terrencelei/Autonomous-Shopping-Cart/docs/assets/cartview-poster.jpg

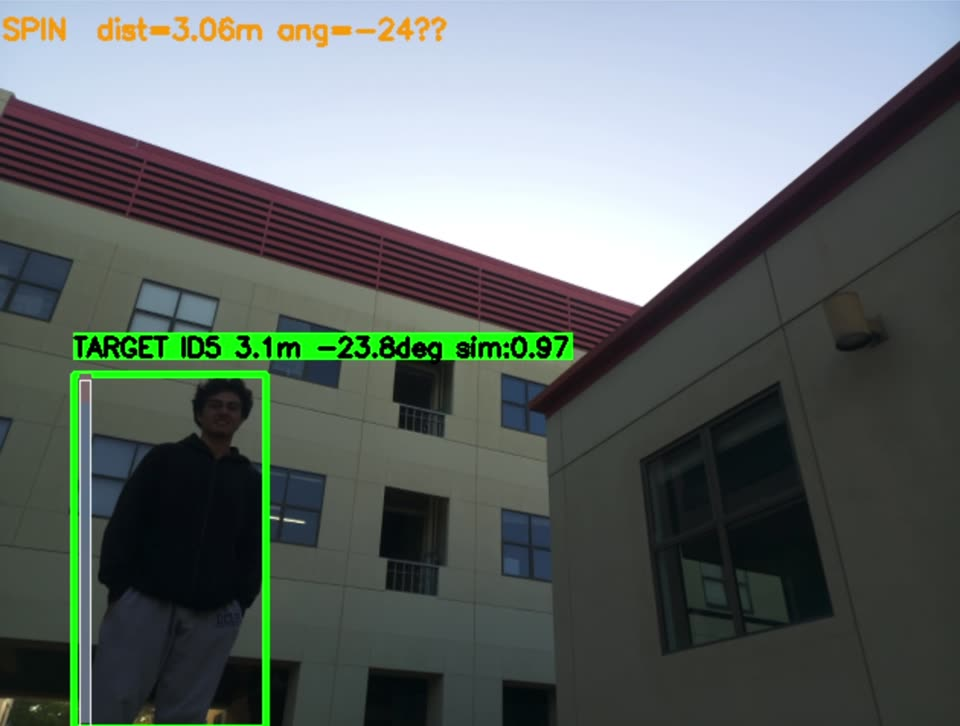
docs/assets/cartview-poster.jpg
