terrencelei/Autonomous-Shopping-Cart/docs/assets/follow-poster.jpg

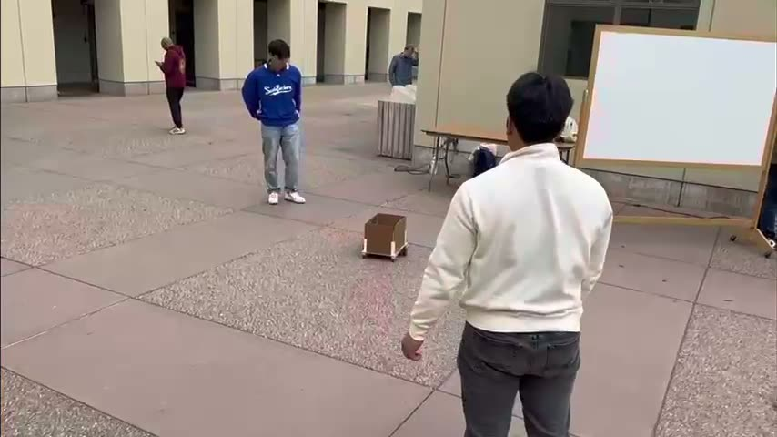
docs/assets/follow-poster.jpg
