terrencelei/Autonomous-Shopping-Cart/docs/assets/cad.jpg

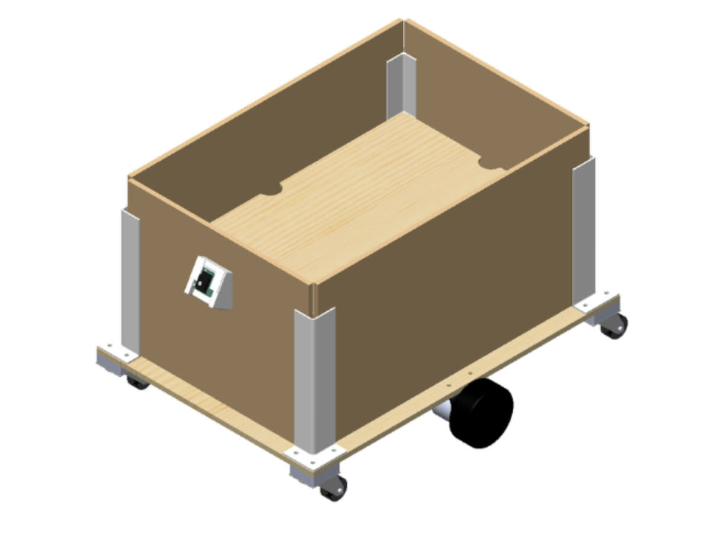
docs/assets/cad.jpg
