terrencelei/Autonomous-Shopping-Cart/docs/assets/cart-photo.jpg

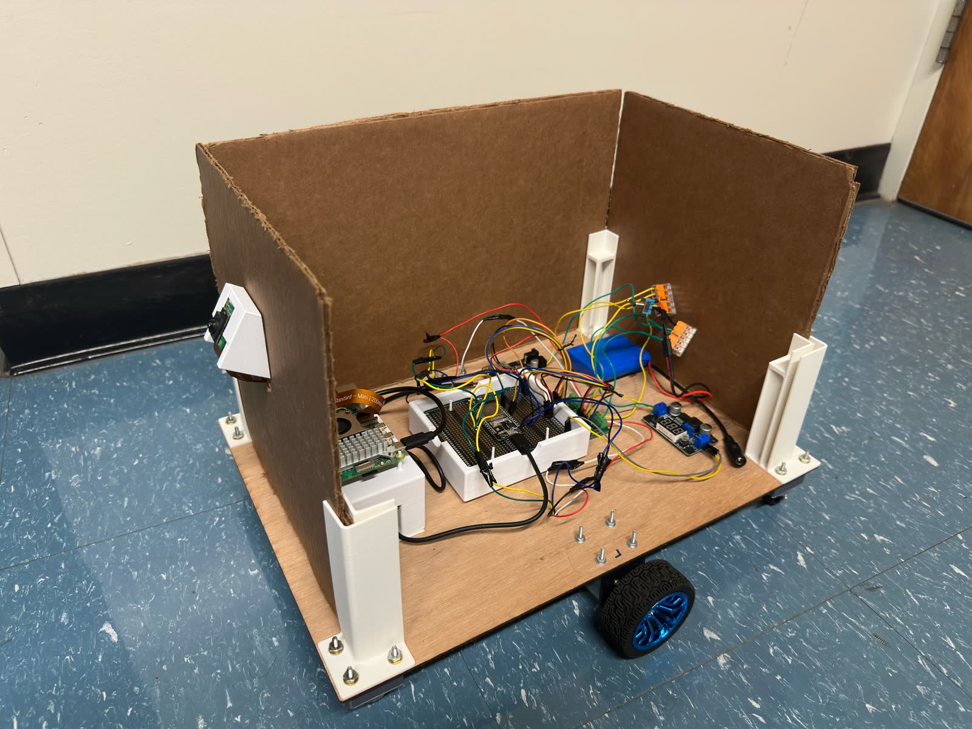
docs/assets/cart-photo.jpg
