terrencelei/Autonomous-Shopping-Cart/docs/assets/og.jpg

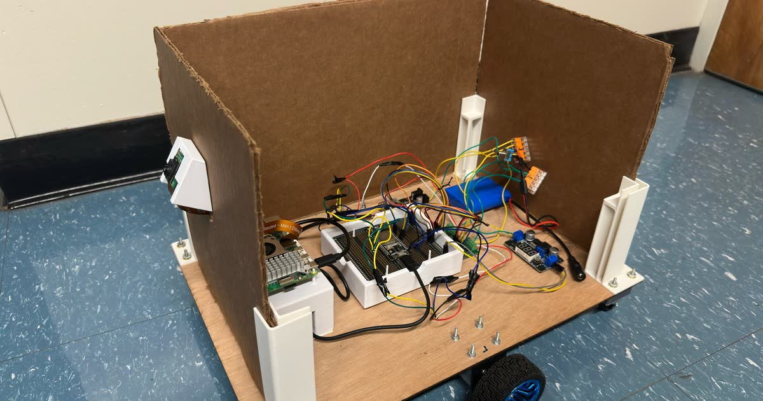
docs/assets/og.jpg
