terrencelei/Autonomous-Shopping-Cart/docs/assets/vision.jpg

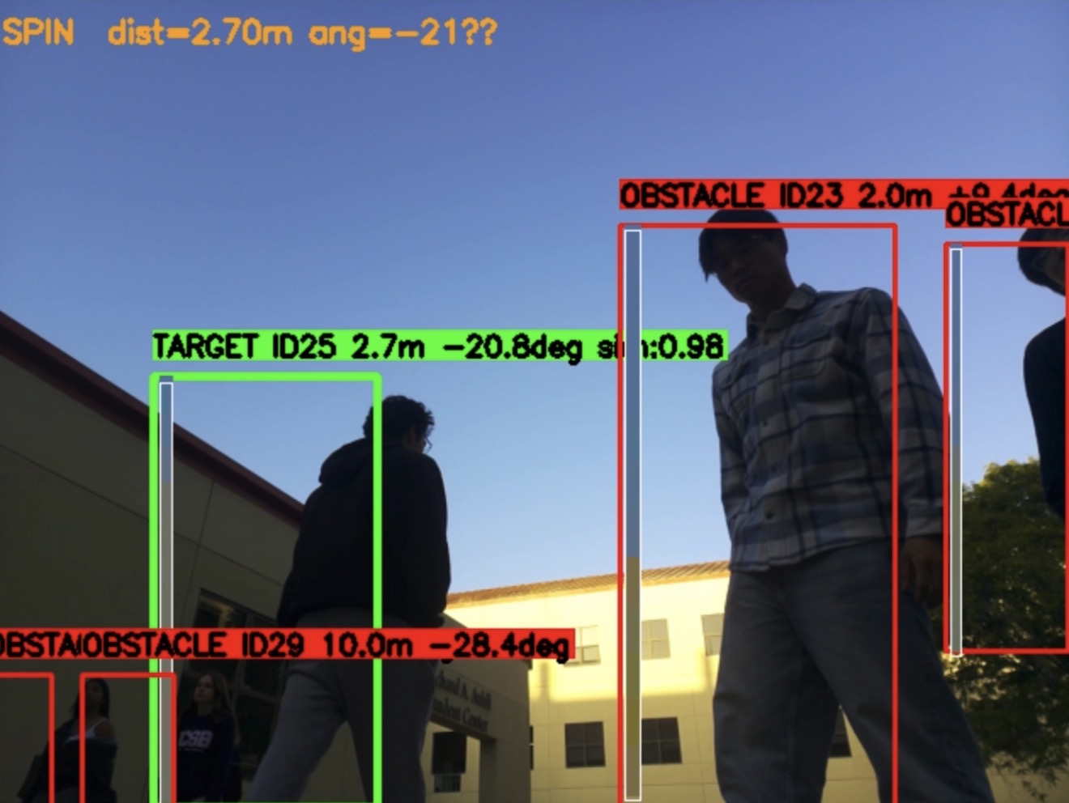
docs/assets/vision.jpg
