terrencelei/Autonomous-Shopping-Cart/(commit log)

2026-04-20 Add UWB cart tracking with Tag and Viewer apps
    Tag app (UWBCart): advertises via MultipeerConnectivity and shares UWB
    discovery tokens for NearbyInteraction ranging with the cart device.
    Viewer app: browses for the Tag phone, connects, and displays the
    shopper's relative position on a top-down radar with distance/angle.
2026-04-21 Improve reliability, add dynamic radar scale, and rename apps
    - Replace silent try? with do/catch error handling in token exchange
    - Add token retry mechanism when receiving peer tokens
    - Skip readings when distance is nil instead of defaulting to 0
    - Add dynamic radar scale that zooms in/out based on distance
    - Rename apps to Shopper and CartView
    - Fix Info.plist preprocessor warnings from apostrophes
    - Use NISession.deviceCapabilities instead of deprecated isSupported
2026-04-21 Fix UWB ranging never starting due to infinite token re-exchange loop
    The re-send logic in didReceive(data:) caused each side to re-send its own
    discovery token whenever it received the peer's token, creating an infinite
    ping-pong. Each loop iteration called niSession.run() with a fresh
    NINearbyPeerConfiguration object, which the NI framework treated as a new
    configuration and restarted the ranging session, preventing distance data
    from ever accumulating.
    Removed the re-send entirely — MCSession .reliable delivery guarantees the
    initial token send arrives, so no retry is needed.
2026-04-21 Enable camera assistance for reliable UWB direction measurement
    isCameraAssistanceEnabled activates the NI framework's sensor fusion
    pipeline (UWB phased array AoA + IMU + camera) on both peers, which is
    required for NINearbyObject.direction to be consistently non-nil. Without
    it, direction is only populated when the peer falls within the optimal UWB
    antenna boresight. Guarded behind iOS 16+ and supportsCameraAssistance
    capability checks so older devices fall back to distance-only gracefully.
    Added NSCameraUsageDescription to both Info.plist files as required by
    the framework even though no camera UI is shown.
2026-04-21 Add convergence guidance and diagnostics for UWB direction
    Camera assistance requires the NI algorithm to converge before direction
    is populated. Added the didUpdateAlgorithmConvergence delegate to detect
    when convergence is pending and surface actionable hints (sweep left/right,
    point at peer, move to brighter area) in the UI via a new convergenceHint
    published property.
    Also added console logging in configureAndRun to confirm whether
    supportsCameraAssistance is true on the test devices, which will show
    whether direction is a hardware limitation or a convergence issue.
2026-04-21 Add distance zeroing calibration
    UWB time-of-flight includes a fixed hardware offset from antenna positions
    and firmware delays, so adjacent phones never read zero. Added a persistent
    calibration offset (UserDefaults) that is subtracted from every raw reading
    and clamped to 0.
    zeroDistance() increments the offset by the current displayed distance so
    the phones can be held together and tapped to zero at any time. resetCalibration()
    removes the offset. The CartView UI shows a "Set Zero" button while ranging
    and a "Reset" button when a non-zero offset is active.
2026-04-21 Show 'Direction locked' status when camera assistance converges
2026-04-21 Fix NIAlgorithmConvergenceStatus build error
    NIAlgorithmConvergenceStatus.Reason.limitedField does not exist in the
    framework. Replaced the reason-specific switch with a simple if-case
    pattern match on .converged to avoid using uncertain API members.
2026-04-21 Update README with current feature set
    Documents direction/camera assistance pipeline, distance calibration
    workflow, updated permission table, and corrected app names.
2026-04-22 Add convergence guidance to Shopper and averaged distance calibration
    Shopper: added didUpdateAlgorithmConvergence delegate so the shopper's
    phone also shows sweep guidance and 'Direction locked' confirmation.
    Both peers now give the user feedback during camera assistance convergence.
    CartView: replaced instant single-sample zeroing with a 20-sample
    averaging calibration. beginCalibration() collects raw distance readings
    over ~2 seconds; the UI shows a circular progress ring and 'Hold phones
    together…' while collecting, then auto-completes and persists the average
    as the offset. This smooths out UWB measurement noise during calibration.
2026-04-22 Replace convergence hint with prominent direction calibration guide
    The old tiny orange text said 'slowly sweep left/right' which is wrong —
    camera assistance convergence needs translational motion (walking), not
    wrist rotation. Wrist sweeping gives too little parallax for the
    visual-inertial odometry to build a reliable pose estimate.
    New DirectionCalibrationGuide panel:
    - Animated phone icon sliding along a track to show lateral walking motion
    - Three numbered steps: point → walk left/right → keep walking until locked
    - Shows live distance while waiting so screen isn't empty
    - Orange card design makes it impossible to miss
    Restructured bottom section into four clean mutually exclus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
2026-04-22 Remove camera assistance — use pure NI flow for distance and direction
    NINearbyObject.direction is optionally provided by the U1 antenna array
    without camera assistance. Camera assistance is an optional enhancement,
    not a requirement. Removed isCameraAssistanceEnabled, the convergence
    delegates, convergenceHint, NSCameraUsageDescription from both plists,
    and the DirectionCalibrationGuide UI.
    Configuration is now the minimal correct flow:
    NISession → NINearbyPeerConfiguration(peerToken:) → niSession.run(config)
    → NISessionDelegate.didUpdate → NINearbyObject.distance / .direction
    When direction is unavailable the readout shows '— face phones together'
    as a simple field-of-vi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
2026-04-22 Add NI diagnostic logging to both session managers
    Logs every key event in the NI delegate path to help diagnose whether
    distance/direction are being received:
    - configureAndRun: confirms niSession.run() is called (or why it was skipped)
    - didUpdate: prints raw distance and direction on every callback, or explains why it returned early (empty objects / nil distance)
    - didRemove: prints removal reason code
    - didInvalidateWith: prints error and surfaces it in the status label
2026-04-22 Update README: remove camera assistance docs, add troubleshooting section
    Reflects pure NI flow (no camera assistance), updated permissions table,
    revised direction/calibration docs, and added signing/direction troubleshooting tips.
2026-04-22 Re-enable camera assistance for direction; add capability logging
    - Enable isCameraAssistanceEnabled on both Tag and Viewer when the
    device supports it — required for reliable direction on U1 iPhones
    - Guard behind supportsCameraAssistance so it degrades gracefully
    - Log device capabilities at session start so we can see what each
    phone reports (preciseDist / cameraAssistance)
    - Add NSCameraUsageDescription to both targets in build settings
2026-04-22 Revert to pure UWB — remove camera assistance, improve direction logging
    U2 chip (iPhone 14 Pro+) provides direction natively without camera.
    Log explicit NIL message when direction is missing so we can diagnose
    whether peer is outside the AoA field of view.
2026-04-22 Use horizontalAngle fallback; log supportsDirectionMeasurement capability
    - Add supportsDirectionMeasurement to capability log so we can confirm
    whether the device hardware reports direction support
    - Log horizontalAngle and verticalDirectionEstimate on every didUpdate
    - Use horizontalAngle (azimuthal bearing) for radar position when the
    full 3D direction vector is nil — gives horizontal angle across a
    wider field of view than the AoA direction vector
    - Add angleDegrees / hasAngle helpers to TagReading
    - UI shows "angle (3D)" or "angle (horizontal)" so source is visible
2026-04-22 Enable camera assistance on Viewer for direction
    Direction algorithm requires camera assistance even on U2 — the OS gates
    AoA angle computation behind ARKit sensor fusion. Enable it silently on
    Viewer when supported; Tag remains pure UWB. No convergence UI needed,
    direction appears automatically with normal movement.
2026-04-22 Provide explicit ARSession to NISession for camera assistance
    Implicit ARSession management by NI was silently failing.
    Explicitly create ARWorldTrackingConfiguration session and pass it
    via niSession.setARSession(_:) before run — this is more reliable
    and ensures camera access is properly established before NI runs.
    Pause/clear ARSession on disconnect and deinit.
2026-04-22 Remove explicit ARSession; add convergence delegate + camera auth logging
    - Drop setARSession — NI manages its own internally when not passed one
    - Add didUpdateAlgorithmConvergence delegate: if it never fires, camera
    assistance is not activating (definitive diagnostic)
    - Log AVCaptureDevice auth status at session start
    - Clean up unused ARSession property and deinit
2026-04-22 Add rolling average smoothing for distance and horizontal angle
    5-sample rolling window applied to both distance and horizontal angle
    before display. Calibration still uses raw samples. Buffers cleared on
    disconnect, timeout, and session invalidation to prevent stale data
    bleeding into a fresh session.
2026-04-22 Fix convergence delegate signature: peer: → for:
2026-04-22 Add angle zeroing — Zero Angle button sets current reading as reference
    Captures the current smoothed horizontal angle as an offset, subtracted
    from all subsequent readings and normalised to [-π, π]. Persisted in
    UserDefaults. Button is disabled until angle data is available.
    Reset All clears both distance and angle offsets.
2026-04-22 Update README to reflect current implementation
    - Camera assistance required for angle on U2 peer-to-peer sessions
    - EMA smoothing explanation and formula
    - Separate distance and angle calibration sections
    - Updated permissions table (CartView needs camera)
    - Corrected requirements (U2 recommended)
    - Expanded troubleshooting section
2026-05-05 Add machine_vision module — YOLO cart/person detection pipeline
    Merges the computer vision component into the autonomous cart project.
    Adds YOLO11-based detection and ByteTrack tracking with center-frame
    target locking, distance/angle estimation, and a live overhead 2D map.
    Includes pre-trained cart model (mAP50 0.793) and training script.
    Updates README to describe the full two-part system (UWB + vision).
2026-05-05 Rename project to Autonomous Shopping Cart, promote vision to primary
    Reorganizes the repo to reflect that camera-based YOLO detection is
    the primary sensing method and UWB positioning is backup/redundancy.
    - machine_vision/ → vision/ (primary system)
    - iOS apps → uwb/ (backup system)
    - README rewritten with vision-first framing and comparison table
2026-05-05 Update yolo_detect: YOLO26n, per-class confidence, improved labels and map
    - Switch person model from yolo11n to yolo26n for faster inference
    - Separate confidence thresholds: person 0.45, cart 0.30 with augment=True
    - Target bounding box color changed from cyan to green
    - Bounding box labels now show PERSON/CART/TARGET instead of OBSTACLE
    - Fix degree symbol rendering (ASCII-incompatible with OpenCV fonts)
    - Overhead map now shows squares for carts, circles for persons, with class labels
    - Model paths resolved relative to script file to fix working directory issues
    [yolo_detect.py]
2026-05-05 Update yolo_detect: distance+angle target scoring, require explicit source arg
    - Replace pixel-proximity target heuristic with weighted distance+angle score
    so the cart locks onto the closest centred person, not just whoever is near
    the frame centre pixel
    - Remove DEFAULT_IMAGE fallback; source argument is now required (exits with
    usage message if omitted)
    - Remove Inside_Costco_Perth.jpg default test image
    [yolo_detect.py]
2026-05-06 Add darknet_detect.py — C++ Darknet backend with yolov4-tiny
    - New darknet_detect.py mirrors yolo_detect.py but runs inference through
    the hank-ai/darknet C++ runtime (yolov4-tiny, ~23 MB) instead of PyTorch
    - Includes auto-patched macOS dylib path and sys.path injection so no env
    vars are needed
    - Adds yolov4-tiny.cfg and coco.names; weights excluded via .gitignore
    - yolo_detect.py: FOV 54°, slant distance correction, distance/angle scale
    constants, EMA smoothing per tracked ID, require explicit source arg
    [yolov4-tiny.cfg]
2026-05-06 Add C++ tracker: cart_tracker.cpp with CMake build
    Full reimplementation using Darknet V3 API for inference and
    track_kalman_t for built-in Kalman filter tracking. Identical
    geometry (slant distance, EMA smoothing, weighted target scoring)
    to the Python pipeline.
2026-05-06 Consolidate to single YOLO pipeline, drop darknet
    - Remove all darknet-related files (cart_tracker.cpp, darknet_detect.py,
    CMakeLists.txt, train_cart.py, yolov4-tiny.cfg, coco.names, cart.pt)
    - Rewrite yolo_detect.py: yolo26n COCO pretrained, person-only mode,
    per-class confidence thresholds, ByteTrack, EMA smoothing, overhead map
    - Add train_combined.py: trains yolo26n-based combined.pt on COCO128
    persons + Roboflow cart dataset for future cart detection
    - Update .gitignore: cover *.pt weights and combined_dataset/
    [yolov4-tiny.cfg]
2026-05-20 Add Pi Camera / IMX500 NPU support, drop train_combined
    - yolo_detect.py: add --picamera, --npu, --no-display flags; PiCameraCapture
    and IMX500Capture classes; correct FOV (66°) for Pi AI Camera; simplify to
    person-only detection pipeline
    - requirements.txt: add supervision (was already imported, missing from list)
    - pathfinding_sim.py: replace IPython.display.Video with subprocess open
    - vision/throttle_watch.sh: Mac thermal monitor for training runs (new)
    - vision/train_combined.py: removed (training is done offline, not on Pi)
    [yolo_detect.py]
2026-05-20 Switch to yolo11n.pt for IMX500 NPU compatibility
    yolo26n architecture (454 modules) is not supported by the ultralytics
    IMX500 exporter which requires exactly 238-239 modules (YOLO11n).
2026-05-20 Fix NPU model path to yolo11n.rpk
    [yolo_detect.py]
2026-05-20 Fix IMX500 coord conversion to use frame metadata
    convert_inference_coords requires frame metadata (contains ScalerCrop),
    not the camera config object.
    [yolo_detect.py]
2026-05-20 Add live FPS and latency overlay to camera feed
2026-05-20 Fix NPU confidence threshold, ByteTrack re-detection, add mode overlay
    - Lower NPU confidence to 0.25 (INT8 quantization reduces raw scores)
    - Lower CPU confidence to 0.35
    - ByteTrack: lost_track_buffer=60 and track_activation_threshold=0.25
    for faster re-detection after subject disappears
    - Overlay now shows NPU/PiCam/CPU mode
    [yolo_detect.py]
2026-05-20 Fix picamera2 RGB/BGR channel swap
    picamera2 returns RGB arrays despite BGR888 config — convert explicitly.
    [yolo_detect.py]
2026-05-20 Cache last NPU detection to prevent flicker between inference cycles
    IMX500 NPU inference runs slower than camera frame rate — reuse the
    last valid detection on frames where get_outputs() returns None.
    [yolo_detect.py]
2026-05-20 Throttle overhead map to every 3 frames to reduce display lag
2026-05-20 Consolidate to single window with PIP map overlay
    - Replace two-window layout with one window: camera feed + mini map in top-right
    - Shrink map from 500x500 to 200x200
    - Simplify map drawing (one distance ring, no labels on dots)
    - Removes second cv2.imshow call
    [yolo_detect.py]
2026-05-20 Render display every 2 frames to improve throughput
2026-05-20 Fix overlay text orange, revert bounding box label to black
    [yolo_detect.py]
2026-05-20 Revert to single FPS counter, sync inference and display frequency
    [yolo_detect.py]
2026-05-20 Fix FPS counter to include display time in measurement
    [yolo_detect.py]
2026-05-20 Fix FPS overlay drawn before imshow so it's actually visible
    [yolo_detect.py]
2026-05-27 Switch vision pipeline to SSD-MobileNetV2 on IMX500 NPU
    The previous YOLO-on-NPU path relied on a custom yolo11n.rpk that the
    current imx500-firmware (0.FF23+3) rejects ("imx500_transition_to_network:
    unable to apply register writes from firmware"). Until the .rpk can be
    regenerated against the current toolchain, the script now uses the factory
    SSD-MobileNetV2 model shipped by the imx500-models package — which runs
    end-to-end on the NPU and detects people (COCO class 0).
    Changes:
    - vision/yolo_detect.py: drop CPU/picamera/YOLO branches; keep only the
    IMX500 + SSD path with the model path hardcoded to
    /usr/share/imx500-models/imx500_network_ssd_mobilenetv2_fpnlite_320x320_pp.rpk.
    Sur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
2026-05-27 Auto-detect headless mode and skip display
    If neither DISPLAY nor WAYLAND_DISPLAY is set (e.g. SSH without X
    forwarding), enable --no-display automatically so cv2.imshow doesn't
    crash the Qt xcb plugin.
    [yolo_detect.py]
2026-05-27 Wire vision UDP feed to Pathfinding_algorithm.py and ESP32
    End-to-end pipeline: yolo_detect.py streams the locked target's
    (distance, angle) over UDP → Pathfinding_algorithm.py converts to map
    coordinates using its current pose and runs A* + state machine →
    ESP32 (USB CDC) drives the two TB9051FTG motor channels.
    Vision side (vision/yolo_detect.py):
    - New PathfinderLink: fire-and-forget UDP sender, one packet per frame
    containing the TARGET row only. Obstacles are still drawn but not
    transmitted (the pathfinder gets obstacles from the static store map).
    - New CLI flags --no-udp, --pathfinder-host, --pathfinder-port.
    - release() and link.close() now run in a finally block so Ctrl-C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
2026-05-27 Document vision → pathfinder → ESP32 runtime pipeline in README
    - Add a pipeline diagram and component table covering vision, pathfinder,
    ESP32, and UWB
    - Document Pathfinding_algorithm.py: setup, usage, state machine, and the
    hardware constants that must be calibrated before driving
    - Document the ESP32 sketch: wiring, build steps, serial protocol, and
    the 500 ms safety watchdog
    - Reframe pathfinding_sim.py as the offline simulator that the runtime
    planner is derived from
    - Update project tree and add troubleshooting entries for the new
    failure modes (no UDP listener, /dev/ttyACM0 not present, MAX_RPM
    miscalibration, stubbed odometry drift)
2026-05-27 Add start_cart.sh / stop_cart.sh for one-command launch over SSH
    Lets you SSH in, place the cart at the start pose, run ./start_cart.sh,
    and disconnect — both Python processes are detached via setsid so they
    survive SSH logout. Each run logs to logs/<ts>-{pathfinder,vision}.log.
    stop_cart.sh kills both by PID file, falls back to pkill, and the
    ESP32's 500 ms watchdog stops the motors regardless.
    Also: add pyserial to vision/requirements.txt (it's a runtime dep of
    Pathfinding_algorithm.py — same Pi, same Python, so one install step is
    enough), ignore logs/, and document the workflow + a warning that the
    cart starts driving the moment the script returns.
2026-05-27 Fix double-prefix on vision PID file path in start_cart.sh
    VISION_PID_FILE is already an absolute path (/tmp/cart-vision.pid), but
    the subshell that launches vision was prepending ../ to it, producing
    ..//tmp/cart-vision.pid — interpreted as relative from vision/, which
    fails. The log path still needs ../ because it's relative to repo root.
2026-05-27 Default ESP32 serial port to /dev/ttyUSB0 (CP2102 bridge)
    The dev board in use has a Silicon Labs CP2102 USB-UART bridge, which
    enumerates as /dev/ttyUSB0 rather than /dev/ttyACM0. Switch the default
    and document both cases in the comment.
2026-05-27 Add pathfinding_arc_test.py: closed-loop arc-tracking test
    Stresses Pathfinding_algorithm.tick() against a target moving along a
    circular arc. Each tick:
    - Places the target at its scripted position on the arc
    - Calls tick() with the cart's current pose (same call the live main
    loop makes after a UDP packet)
    - Integrates differential-drive kinematics from the returned wheel
    speeds and updates the pose
    Output is a four-panel matplotlib figure: trajectory with heading
    arrows, v_forward command over time, omega command over time, and
    tracking error. The console summary reports FOV-hit percentage, mean /
    max distance to target, mean commanded speed, and peak turn rate.
    The store map is ove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
2026-05-27 Add systemd units for boot-time autostart
    Two service units (cart-pathfinder.service + cart-vision.service) and a
    one-shot installer. Vision depends on the pathfinder via Requires= +
    After=, plus a 2s ExecStartPre sleep so the UDP receiver is bound
    before vision starts sending. KillSignal=SIGINT routes shutdown
    through the pathfinder's finally: block so motors get a zero command
    before exit; the ESP32's 500 ms watchdog cuts them regardless.
    The installer is idempotent and supports --no-enable for users who
    want the units present but autostart off (use ./start_cart.sh
    manually). README documents the safety caveat: autostart means the
    cart begins driving the moment the Pi finishes booting.
2026-05-27 Add --test mode for boot autostart: arc test only
    Three boot modes now selectable via install.sh:
    --test → cart-arc-test.service (oneshot at boot, generates PNGs)
    --live → cart-pathfinder + cart-vision (the previous default)
    --none → install units but autostart nothing
    The installer is idempotent: it stops + disables everything, then flips
    to the requested mode, so switching back and forth is safe.
    Test mode is useful while motors / pinout / camera are still being
    tuned — boots the Pi, runs the simulator, exits. Switch to --live once
    the hardware is ready.
2026-05-27 Drive the real motors during pathfinding_arc_test
    Default behaviour now opens the ESP32 serial port and sends
    (v_left, v_right) on every tick, exactly like the live pathfinder
    does. The cart traces (approximately) the simulated trajectory.
    - 3 s countdown before motion starts, so the user can step back
    - Real-time pacing inside the loop when motors are connected
    (otherwise 250 commands would fire in <1 s)
    - motors.stop() in finally so the cart doesn't keep running if the
    script crashes
    - Auto-fallback: if MOTOR_UART_PORT (currently /dev/ttyACM0 per the
    upstream constant) doesn't exist, try /dev/ttyUSB0 next — covers
    the CP2102 dev boards without forcing the user to edit the consta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
2026-05-27 Plot measured wheel RPM and encoder totals in the arc test
    The ESP32 streams E,<l>,<r> tick counts at 20 Hz and MotorDriver
    already exposes read_encoder_deltas(). The arc test now consumes that
    each tick and produces:
    - pathfinding_arc_test_motors.png — two-panel:
    * Cumulative encoder ticks per wheel over time
    * Commanded vs measured RPM, left and right (4 lines)
    Lets you eyeball motor calibration: if measured tracks commanded the
    RPM mapping is right; if it lags or saturates flat, MAX_RPM in
    cart_motor.ino needs tuning.
    - Console summary now lists total wheel revolutions per side at the
    end of the run.
    The plot is only emitted when motors were actually driven; --no-driv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
2026-05-27 Enable encoder pull-ups in cart_motor.ino
    Encoder pins are adjacent to the motor PWM pins on the ESP32 (PWM 18/19
    ↔ ENC 32/33, PWM 22/23 ↔ ENC 25/26). With plain pinMode(... INPUT),
    disconnected or open-drain encoder lines float and capacitively pick
    up PWM edges from the neighbouring motor pins, generating phantom ISR
    counts. Symptom: the arc test plot shows the right wheel "moving"
    while the motor isn't physically spinning.
    INPUT_PULLUP pulls the line to a stable high so coupled noise doesn't
    cross the trigger threshold. Comment notes the alternative for
    push-pull encoders.
    [cart_motor.ino]
2026-05-27 Add sniff_encoder.py — quick raw-serial diagnostic
    Prints every changed line from /dev/ttyUSB0 for 15s so we can verify
    the ESP32 firmware is actually emitting E,<l>,<r> packets and that
    pushing each wheel by hand moves the counter. Easier than pasting a
    multi-line one-liner over SSH, which kept getting indented by
    bracketed-paste mode.
2026-05-27 Make sniff_encoder.py more verbose
    Print every E,<l>,<r> line (not just changes), flag when each side
    moves with *L* / *R*, and report final counts + total packet count.
    Easier to tell apart "encoders alive but unmoved" from "no packets at
    all" from a single 20s run.
2026-05-27 Match dual_motor_test.ino's count+delta format in sniff_encoder.py
    Each line now reads
    L= <count> (d <delta>) R= <count> (d <delta>) *L* *R*
    with the *L* / *R* flag firing when that side's count changed since the
    previous packet. Easier to spot real encoder motion at a glance.
2026-05-27 Quadrature decoding in cart_motor.ino + matching ENCODER_PPR
    cart_motor.ino now mirrors the dual_motor_test 4x quadrature decoder:
    CHANGE interrupts on both A and B pins, two-bit state machine resolves
    each transition into ±1 or 0. Adds LEFT_ENC_DIR / RIGHT_ENC_DIR knobs
    for sign flipping per side.
    Pathfinding_algorithm.py: ENCODER_PPR is now expressed as
    11 (JGB37 base cycles) × 4 (quadrature edges) × GEAR_RATIO
    with GEAR_RATIO exposed as a named constant. Default 5 (~1000 rpm
    output JGB37 variant) — adjust to whatever ratio is on your gearbox
    sticker, or measure empirically by marking one wheel and turning it
    exactly one revolution while watching the encoder count.
    [cart_motor.ino]
2026-05-27 Invert left encoder sign in sniffer and pathfinder
    JGB37 encoders on the left side count backwards under forward motion
    because the A/B channels mirror the right side's wiring. Both files now
    apply LEFT_SIGN/LEFT_ENC_SIGN = -1 at parse time, so cumulative counts
    and deltas display in the conventional "forward → positive" direction.
    RIGHT side stays positive.
    Single-constant change keeps it easy to flip back or apply to the other
    side later. The firmware itself reports raw counts unchanged — sign
    correction lives in Python so re-flashing isn't needed.
    [sniff_encoder.py]
2026-06-01 Tighten arc test: start 1 m higher, 0.5 m diameter circle
    ARC_RADIUS 0.8 → 0.25 m (0.5 m diameter), START_POS y 0.5 → 1.5 m.
2026-06-01 Switch test target path from arc to 0.5 m square box
    Replaces ARC_CENTRE/RADIUS/OMEGA with BOX_CENTRE/SIDE/SPEED.
    target_at() now walks the perimeter counter-clockwise at 0.15 m/s.
    Plots updated to draw a Rectangle instead of a Circle.
    Run extended to 40 s to cover ~3 laps.
2026-06-01 Rework test as waypoint path execution, no camera/target chasing
    Cart now drives corner-to-corner around the 0.5m box using tick()
    with fixed waypoints. Advances to next corner when within
    WAYPOINT_TOLERANCE (0.08m). Removes moving-target concept entirely.
2026-06-01 Integrate Pathfinding_algorithm directly into yolo_detect
    Removes the UDP PathfinderLink hop. yolo_detect now imports
    Pathfinding_algorithm as P, creates MotorDriver + Odometry locally,
    and calls P.tick() at P.DT rate (10 Hz) while the camera still
    runs at 30 fps. Replaces --pathfinder-host/--pathfinder-port flags
    with a single --no-drive flag.
    [yolo_detect.py]
2026-06-01 Fix tick() API mismatch; arc test now simulates subject walking the box
    yolo_detect: pass raw (dist_m, angle_deg) directly to P.tick() —
    the relative_to_absolute conversion now happens inside tick() itself.
    pathfinding_arc_test: subject walks the box at BOX_SPEED (0.15 m/s);
    absolute_to_reading() converts subject position to camera-frame reading
    each tick so tick() exercises the same code path as the real camera.
    Cart follows using the new PD hold controller (hold at HOLD_DIST_M).
    TOTAL_S auto-set to one full subject lap.
    [yolo_detect.py]
2026-06-01 Update arc test and yolo_detect for refactored Pathfinding_algorithm API
    Renamed symbols:
    chunk_map → CHUNK_MAP (list-of-lists, not numpy array)
    ROBOT_SPEED_MPS → MAX_SPEED
    TURN_SPEED_RAD → MAX_TURN
    WHEEL_TRACK_M → TRACK_M
    MOTOR_UART_PORT → MOTOR_PORT
    robot_pos/heading → S.pos / S.heading
    MotorDriver(port, baud) → MotorDriver() (no args)
    motors.send_velocities() → motors.send()
    Odometry(pos, hdg, reader) → Odometry(reader)
    odometry.update(dt) → odometry.update()
    bearing_to/angle_diff → _bearing/_adiff
    velocities_to_wheel_commands → _wheel_commands
    robot_state → S.mode
2026-06-01 Replace box path test with 360° spin-in-place test
    Spins at MAX_TURN until 2π radians accumulated, then stops.
    Plots heading-over-time and turn rate. Motor mode saves encoder counts.
2026-06-01 Add LEFT/RIGHT_MOTOR_SIGN to fix spin direction
    Left motor is mirrored on the chassis (same reason LEFT_ENC_SIGN=-1).
    LEFT_MOTOR_SIGN=-1 negates the RPM command so it drives the correct
    direction. Flip to +1 if the cart drives backwards instead of spinning.
2026-06-01 Handle MOTOR_PORT vs MOTOR_UART_PORT naming across P versions
2026-06-01 Fix UnboundLocalError: restore P.MOTOR_PORT assignment in run()
    replace_all incorrectly changed P.MOTOR_PORT = chosen to
    _MOTOR_PORT = chosen inside run(), making Python treat _MOTOR_PORT
    as a local variable.
2026-06-01 Set default MOTOR_PORT to /dev/ttyUSB0 (CP2102 bridge)
2026-06-01 Stop spin on real encoder ticks instead of simulated radians
    When driving, loop exits after TICKS_360 absolute left-encoder ticks
    (π * TRACK_M / WHEEL_CIRC * ENCODER_PPR ≈ 870 at current calibration).
    --no-drive still uses the simulated 2π radian fallback.
2026-06-01 Flush encoder buffer before spin loop to avoid false early stop
    Encoder packets accumulate during the countdown; draining them first
    prevents the first read from instantly tripping the tick target.
2026-06-01 Fix spin test encoder calibration
2026-06-01 Handle single encoder spin tests
2026-06-01 Avoid empty encoder average in spin test
2026-06-01 Report encoder angle in spin test
2026-06-01 Recalibrate encoder PPR from spin test
2026-06-01 Plot encoder angle in spin test
2026-06-01 Tune encoder PPR from spin measurement
2026-06-01 Add spin test encoder safety timeout
2026-06-01 Revert "Add spin test encoder safety timeout"
    This reverts commit 35456bb52c940dbb29ed25529723662528809dec.
2026-06-01 Refine encoder PPR from measured spin
2026-06-01 Increase ESP32 encoder report rate
2026-06-02 Calibrate distance constants to match measured real-world distances
2026-06-02 Add obstacle avoidance and world-map live plot
    [yolo_detect.py]
2026-06-02 Integrate obstacle avoidance with CHUNK_MAP/A* and lane-parallel follow mode
    [yolo_detect.py]
2026-06-02 Update README: obstacle avoidance, lane-parallel follow, world map, calibration
2026-06-02 Swap left/right motor labels across all files
    [cart_motor.ino, sniff_encoder.py, yolo_detect.py]
2026-06-02 Correct distance estimate for 29-degree upward camera tilt
    [yolo_detect.py]
2026-06-02 Apply DISTANCE_OFFSET_M to raw_depth before tilt and angle corrections
    [yolo_detect.py]
2026-06-02 Improve target filtering and obstacle selection
2026-06-02 Update vision distance calibration
2026-06-02 Calibrate encoder pulses per revolution
2026-06-02 Add ESP32 wheel speed PID control
2026-06-02 Use PI control for wheel speed
2026-06-02 Fix WheelPid Arduino prototype declaration
    [cart_motor.ino]
2026-06-02 Apply camera angle offset calibration
2026-06-02 Correct left right motor labeling
    [cart_motor.ino, yolo_detect.py]
2026-06-02 Reduce centering gain and motor RPM limit
2026-06-02 Increase centering response and motor RPM limit
2026-06-02 Add centering anti-stall limits
    [cart_motor.ino]
2026-06-02 Soften centering anti-stall response
    [cart_motor.ino]
2026-06-02 Add stall-detection ramp and encoder-vs-commanded speed plot to slow-spin mode
2026-06-03 Tune slow spin stall test
2026-06-03 Limit center search motor speed
2026-06-03 updated stall rpm constants
2026-06-03 increased stall kick rpm
2026-06-03 Release center kick after encoder ticks
2026-06-03 updated stall values
2026-06-03 new stall constants
2026-06-03 increased stall constants
2026-06-03 Tighten pathfinding center deadband
2026-06-03 Rekick stalled pathfinding search
2026-06-03 Stabilize target lock after movement
    [yolo_detect.py]
2026-06-03 Improve slow spin stall search
    [yolo_detect.py]
2026-06-03 Require sustained encoder ticks in slow spin
2026-06-03 Use cumulative encoder RPM for slow spin stall
2026-06-03 Convert encoder RPM to wheel RPM
2026-06-04 Add follow mode to pathfinding_arc_test: distance-only PD with kick stall combat
    Adds --mode follow to pathfinding_arc_test.py, which drives the cart
    forward/backward using the same PD controller as IN_VIEW (DIST_KP/DIST_KD)
    but forces omega=0 so angle correction is completely removed. Isolates
    distance control for tuning without steering interference.
    Uses the same kick-on-start/direction-change stall combat as center mode
    (FOLLOW_KICK_RPM=8, FOLLOW_KICK_RELEASE_TICKS=30). Also adds --sim-dist
    flag for hardware-free testing, _plot_follow for PNG output, and documents
    all four test modes in README.
2026-06-04 follow mode: use live IMX500 camera as default distance source
    Adds run_follow_camera (mirrors run_center_camera) which reads target
    distance from the IMX500/ByteTrack pipeline instead of UDP. Default for
    --mode follow is now the live camera; --source udp or --sim-dist fall back
    to the UDP/simulation path. Omega is still forced to zero in all cases.
2026-06-04 follow mode: use CENTER_* stall constants directly, remove FOLLOW_ aliases
    Removes FOLLOW_KICK_RPM, FOLLOW_KICK_RELEASE_TICKS, FOLLOW_MIN_RUN_RPM and
    replaces all references with CENTER_KICK_RPM (8), CENTER_KICK_RELEASE_TICKS
    (30), CENTER_MIN_RUN_RPM (0.3) and CENTER_START_RPM so follow and center
    modes share a single set of stall-combat parameters.
2026-06-04 follow mode: negate right wheel to correct forward/reverse direction
    RIGHT_MOTOR_SIGN=-1 in motors.send() already inverts the right wheel for
    differential drive. For straight motion (omega=0) both vl and vr are equal
    and positive, so the right motor was getting an opposite-signed command and
    spinning the wrong way. Negate v_right before send in run_follow and
    run_follow_camera to cancel the sign, matching the physical motor direction.
    Spin/center modes are unaffected.
2026-06-04 revert: restore correct motors.send for follow mode
    The negation fix overcorrected. L+X R-X (original) is correct for straight
    forward: left forward, right motor reversed so R-X also drives wheel forward.
    L+X R+X (the "fix") drove right wheel backward, producing a spin.
2026-06-04 Flip right wheel command in follow mode
2026-06-04 Calibrate encoder PPR from spin test
2026-06-04 spin: drain coast ticks after stop until encoders go quiet
    After reaching TICKS_360, stop motors immediately then keep reading encoder
    deltas every DT until 10 consecutive empty reads. This captures all overshoot
    ticks from motor coasting so the final reported degrees include the full arc
    travelled, not just what was measured before the stop command.
2026-06-04 Fix one meter forward wheel signs
2026-06-04 fix: correct right motor direction in move_forward_one_meter
    forward_wheel_commands was negating v_right, but MotorDriver.send already
    applies RIGHT_MOTOR_SIGN=-1 to the right wheel. The double negation drove
    the right motor backward, causing the cart to spin right instead of going
    straight. Pass the same speed to both sides and let the motor driver handle
    the sign convention.
2026-06-04 fix: set LEFT_MOTOR_SIGN=-1 and negate vl for positive L forward command
    The 7e575ff label swap incorrectly set LEFT_MOTOR_SIGN=+1. The left motor
    is physically reversed like the right, so LEFT_MOTOR_SIGN=-1 is correct.
    In move_forward_one_meter, negate vl so L_cmd = -1*rpm(-speed) = +rpm,
    giving a positive commanded RPM when driving forward.
2026-06-04 Fix forward drive motor signs
    [cart_motor.ino]
2026-06-04 Fix left encoder feedback sign + add windup guard
    The left encoder counts opposite to the right for forward motion, so the matching LEFT_RPM_SIGN/RIGHT_RPM_SIGN gave the left speed loop positive feedback: its integrator wound up and drove the motor to full throttle (the "left spins way faster" runaway). Set LEFT_RPM_SIGN=+1 so both loops are negative-feedback and track to the same RPM, consistent with the Pi's own LEFT_ENC_SIGN/RIGHT_ENC_SIGN.
    Add a feedback-fault guard: if a wheel's integrator stays pinned at its limit for FAULT_TIME_S (lost/disconnected/reversed encoder, or a stalled wheel), latch that motor off and print FAULT L/R once instead of running away. Re-arms on the next command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
    [cart_motor.ino]
2026-06-04 Set MOTOR_SIGN=+1 so a forward command drives forward
    With the left encoder feedback sign fixed, both wheels track together, but the cart translated backward for a forward command — forward was globally inverted. Flip LEFT_MOTOR_SIGN and RIGHT_MOTOR_SIGN from -1 to +1 to reverse drive direction. Loop stability is set by RPM_SIGN (unchanged), so this cannot reintroduce the runaway. Pending on-hardware confirmation of forward + straight.
2026-06-04 Add rpm_log.py: log + graph commanded vs measured wheel RPM
    Mirrors move_forward_one_meter's kick-then-run command profile but records every tick (commanded RPM sent to the ESP32, plus encoder deltas) to a CSV and plots commanded vs measured RPM per wheel. Measured is derived from encoder deltas in the same sign convention and smoothed over a short window; forward motion reads as negative RPM. Use to diagnose the backward/turning behavior: sign shows direction, left-vs-right magnitude shows the turn, measured-vs-commanded shows whether each loop tracks.
2026-06-04 Fix speed-loop feedback signs from runaway data; add overspeed cutoff
    The rpm_log capture showed both wheels accelerating to ~1000 rpm on a 0.5 rpm command — positive feedback in both speed loops. The runaway direction gives the correct stable signs directly: RIGHT_RPM_SIGN +1 (was -1, unstable), LEFT_RPM_SIGN -1 (was +1, an earlier wrong guess). Revert the Pi MOTOR_SIGN flip to -1/-1 so a forward command drives forward with the now-stable loop.
    Add a one-tick overspeed cutoff (|measured| > 2*MAX_RPM): the integrator-rail guard let the 1000-rpm runaway run unchecked, so latch off immediately when measured blows past a sane multiple of MAX_RPM. Bump the setup banner to v3 so a successful f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
    [cart_motor.ino]
2026-06-04 Set MOTOR_SIGN=+1 for forward (runaway run was spinning forward)
    User confirmed the rpm_log capture — taken at MOTOR_SIGN=+1 — had the wheels turning the correct (forward) direction; only the speed was out of control. With the v3 firmware now stabilizing both loops, keep MOTOR_SIGN=+1 so forward stays forward. Reverts the -1/-1 from the previous commit, which assumed the wrong forward convention.
2026-06-04 Trim test code to spin, center, follow, and encoder sniff
    Remove standalone test scripts that aren't part of the kept test set:
    - pathfinding_sim.py (offline 2D simulator)
    - move_forward_one_meter.py (forward drive test)
    - rpm_log.py (commanded-vs-measured RPM logger)
    - tracker.py (legacy single-target follower, not imported by runtime)
    Strip the slow-spin stall-characterisation mode out of
    pathfinding_arc_test.py, leaving only the angle spin, angle-only center,
    and forward-only follow modes. Drop the now-unused --direction flag and
    the STALL_* parameters. Update README and .gitignore to match.
    Kept: pathfinding_arc_test.py (spin/center/follow) and sniff_encoder.py.
2026-06-04 Add combined track mode: drift-compensated spin + PI distance follow
    Implements the spin/displacement controller sketched in the module
    docstring as a new '--mode track' in pathfinding_arc_test.py:
    - drift(initial, final, inertia): coast model, (initial-final)*inertia.
    - spin(theta): open-loop point turn — breakaway kick (8 rpm / 30 ticks)
    then a steady turn at TRACK_TURN_RPM, with the kick angle and the
    kick->turn / turn->0 inertial coast subtracted so the total swept
    angle lands on theta.
    - TrackController: per-tick loop — re-centre via spin() when the FOV
    angle leaves the +/-8 deg band (skipping distance that tick), else PI
    distance hold (kick-started, clipped to MAX_SPEED)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
2026-06-04 Add follow.py: standalone reactive follower from the pseudocode
    Single-process spin + displacement controller built directly from the
    control sketch. Reuses vision/yolo_detect.py for calibrated target
    distance/angle and the proven kick (8 rpm / 30 encoder ticks); speaks the
    ESP32 RPM protocol directly. Independent of Pathfinding_algorithm.py's A*
    state machine (imports only hardware/calibration constants).
    - drift(initial, final, inertia): coast model.
    - spin(theta): breakaway kick then steady turn, kick angle + inertial
    coast subtracted so the total swept angle lands on theta; closed-loop
    on encoder-measured angle, open-loop timing fallback.
    - FollowController: per-tick PI distance hol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
    [follow.py]
2026-06-04 Make follow.py fully standalone: clone hardware specs from algorithm
    Drop the 'import Pathfinding_algorithm as P' dependency. ENCODER_PPR,
    wheel diameter, track width, gear ratio, encoder/motor signs, serial
    port/baud, MAX_SPEED, DT, and HOLD_DIST are now defined locally in a
    HARDWARE/DIMENSIONAL SPECS block (kept in sync manually).
2026-06-04 Make spin() angle deadband a named constant (SPIN_DEADBAND_DEG)
    Replaces the hardcoded 0.5deg no-op floor inside spin() with a tunable
    constant alongside the other spin parameters.
    [follow.py]
2026-06-04 Tick-gated forward kick; move kick out of FollowController
    The distance controller no longer self-seeds S=KICK_RPM (that one-tick
    kick never confirmed the cart actually broke free). FollowController.step
    is now pure PI + steering and returns (S, rpm_diff); wheel mixing moves
    to a mix_wheels() helper.
    Breakaway is handled by a new encoder-confirmed Kick class, mirroring
    spin(): on departure from rest it floors the forward speed at KICK_RPM
    until KICK_TICKS (30) of encoder movement accumulate, or KICK_TIMEOUT_S
    elapses. The run loop reads encoder deltas each tick, drives the Kick,
    applies the floor, mixes, and sends.
    [follow.py]
2026-06-04 Add --trace to follow.py: echo serial traffic + control-flow calls
    When --trace is set, the terminal acts as a live monitor: prints the raw
    RX encoder packets (E,<l>,<r>) and net deltas, the TX wheel commands
    (L<rpm> R<rpm>), and which control functions fire each tick (step PI /
    spin() / kick.arm()+release / stop / target lost). Gated by a module
    TRACE flag set from the new CLI flag; off by default.
2026-06-04 Fix follow_straight spin handling
    [follow_straight.py]
2026-06-04 Update yolo_detect.py
    updated weighting based on proportions from empirical data (camera screenshots)
2026-06-04 Add constant motor speed firmware sketch
2026-06-04 Use direct LEDC motor outputs
2026-06-04 Make cart motor firmware open loop
2026-06-04 Fix target similarity logging
    [yolo_detect.py]
2026-06-04 Set MAX_RPM = 75 in follow.py and follow_straight.py
    Was 140.9 (follow.py, exceeded the firmware full-PWM point) and 50
    (follow_straight.py). 75 is a single shared cap below cart_motor.ino's
    ~100 RPM full-PWM mapping.
2026-06-04 follow_straight.py: enforce straight-only (drop unused angle from step)
    step() no longer takes angle_deg — distance is its only input, so no
    steering term can be added by accident. The run loop already sent
    l_rpm = r_rpm = S (identical wheels); angle is now read for the status
    readout only. No behavioral change; makes straight-only structural.
    [follow_straight.py]
2026-06-04 Revert follow.py KI_DIST back to 15 (keep as-is)
    KP_DIST stays 30; follow_straight KP_DIST stays 30.
    [follow.py]
2026-06-04 follow_straight.py: forward-only, never reverse when shopper too close
    The symmetric deadband meant a too-close shopper (error<0) produced a
    negative target speed -> reverse. Make it asymmetric: stop (target_s=0)
    at hold distance or closer; only drive forward when the shopper is
    beyond hold+deadband, with target_s clamped to [0, MAX_RPM] so the KD
    term can ease off but never reverse.
    [follow_straight.py]
2026-06-04 follow.py: forward-only distance control (clamp S >= 0, never reverse)
    Matches follow_straight: the far-branch integrator clip was [-MAX_RPM,
    MAX_RPM], so a fast approach (strongly negative dx) could drive S
    negative -> reverse. Clamp to [0, MAX_RPM]; the too-close branch already
    stops. Steering wheel-mixing (S +/- rpm_diff) is unaffected.
    [follow.py]
2026-06-04 follow_straight.py: encoder-driven straight-line heading hold
    Combats drift on the open-loop ESP32 firmware (equal RPM command !=
    equal wheel speed). Each tick, accumulate the L-R encoder imbalance and
    apply a small differential trim (STRAIGHT_KP/KD, capped) so the lagging
    wheel speeds up and the two wheels' travel stays equal. Encoder-driven,
    not camera/angle steering; reset on stop / new forward segment; wheels
    clamped to [0, MAX_RPM] so neither reverses.
    [follow_straight.py]
2026-06-04 follow.py: make spin non-blocking (fixes on-ground lag)
    The blocking, encoder-gated spin() froze the camera/control loop for the
    full turn — fine with wheels lifted (instant free-spin) but seconds-long
    on the ground (loaded wheels grind to KICK_TICKS / hit the timeouts),
    causing the 'lag like crazy' symptom.
    Replace it with a non-blocking Spinner class: start() captures the turn,
    update(d_l,d_r) advances ONE tick per camera frame and returns the wheel
    command (or None when done). Same kick->steady-turn drift-compensated
    profile, now spread across frames and bounded by KICK_TIMEOUT_S /
    SPIN_TURN_TIMEOUT_S so a stuck turn exits instead of blocking. The run
    loop engages/continues it; FollowC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
    [follow.py]
2026-06-04 follow.py: fix wrong-way angle corrections + kick/turn tuning
    Add STEER_SIGN (applied to both in-band steering and the re-centre spin)
    and flip it so the cart turns toward the target on this hardware; the
    prior -angle_deg polarity drove corrections the wrong way. Single knob
    keeps steering and spin consistent.
    Also includes constant tuning: KICK_RPM 18->25, KICK_TICKS 45->30,
    SPIN_KICK_RPM 9->12, TURN_RPM 6->5.
    [follow.py]
2026-06-04 follow.py: search/reacquire when target leaves the frame
    When the target is lost, after a SEARCH_GRACE_S grace period the cart now
    rotates toward the side it was last seen (last_angle_deg) to bring it
    back into view, instead of just stopping. New non-blocking Searcher:
    breakaway kick at SPIN_KICK_RPM (released after KICK_TICKS) to beat
    stall, then a steady sweep at SEARCH_RPM. Cancels the instant a target
    reappears; gives up (holds still) after SEARCH_MAX_DEG or
    SEARCH_TIMEOUT_S. New Mode label: SEARCH.
    [follow.py]
2026-06-04 Update follow.py
    implemented inertia calibration sequence
2026-06-04 Update follow.py
    encoder plotting
2026-06-04 follow.py: ramp the forward kick on stall instead of giving up
    When the cart hasn't broken free within KICK_TIMEOUT_S, Kick now raises
    its floor by KICK_RAMP_STEP (capped at MAX_RPM) and keeps trying, rather
    than deactivating. Kick exposes .rpm (the ramping level) and the run loop
    floors S at kick.rpm. Releases as before once KICK_TICKS of movement
    confirm breakaway.
    [follow.py]
2026-06-04 follow.py: drive forward to last-known position when target lost too far ahead
    Adds a non-blocking Pursuer alongside the rotate-Searcher. When the target
    is lost, the run loop picks by last-seen angle: |angle| > LOST_SIDE_ANGLE_DEG
    -> rotate-search (left the side); else -> pursue, driving straight forward to
    the last-known position until reacquired or PURSUE_MAX_M covered. Pursuer
    kicks (ramping to beat stall) then drives at PURSUE_RPM. Fixes losing the
    target when it gets too far ahead. New Mode: PURSUE.
    [follow.py]
2026-06-04 Update README for open-loop motor tests
2026-06-04 follow.py: declare ANGULAR_INERTIA global in run() (was a dead local)
    run() assigned ANGULAR_INERTIA = calibrate_angular_inertia(...) without a
    global decl, making it a dead local. The calibration function set the
    module global itself so compensation still applied, but the run-level
    assignment was a footgun. Declare it global so the assignment is authoritative.
2026-06-04 README: document follow.py startup inertia calibration + follow_straight heading-hold
    - follow.py: add the calibrate_angular_inertia startup step (and its skip
    conditions); note ANGULAR_INERTIA is auto-measured, not just a placeholder.
    - follow_straight.py: document forward-only (no reverse) behavior, the
    damped-proportional distance speed, and the encoder-driven straight-line
    heading hold (STRAIGHT_KP/KD/TRIM_MAX); refresh the constants table.
2026-06-04 follow.py: basic obstacle hold — stop advancing if an obstacle blocks the path
    When following, if any OBSTACLE detection is closer than the target (by
    OBSTACLE_MARGIN_M) and within +/-OBSTACLE_BLOCK_DEG of straight ahead,
    force S=0 (Mode: BLOCKED) so the cart holds position instead of driving
    into it; steering still keeps it aimed at the target. Resumes normal
    follow automatically once the obstacle clears. Minimal: stops only, no
    routing around. (Also carries in-progress constant tuning.)
2026-06-04 follow.py: remove unused MAX_SPEED, raise MAX_RPM to 100, OBSTACLE_BLOCK_DEG to 10
    MAX_SPEED was dead (cap is the explicit MAX_RPM). Raise the wheel-RPM cap
    to 100 (cart_motor.ino's full-PWM point) and narrow the obstacle 'in the
    way' band to +/-10deg. README updated.
2026-06-04 follow.py: return-home on uncommanded ~180deg spin + revert OBSTACLE_BLOCK_DEG to 15
    Add encoder dead-reckoning (Odometry) and a non-blocking ReturnHome
    maneuver. While the cart is commanding a stop, rotation the encoders see
    is accumulated as 'uncommanded'; ~180deg (+/-30) triggers a return to the
    start pose along a direct line: turn-to-face-home, drive (steering on the
    odometry bearing), turn-to-original-heading. New modes RETURN/HOME.
    Run loop refactor: read encoders once per tick at the top, update
    odometry, detect the spin, and make return-home the highest-priority
    state; unified the single send_rpm. Also reverted OBSTACLE_BLOCK_DEG 10->15.
    [follow.py]
2026-06-04 follow.py: slip rejection for odometry (free-spin wheel) + trust gripping wheel
    Add deslip(): a free-spinning wheel over-reports ticks. When the wheels
    diverge beyond the commanded differential by more than
    SLIP_DIFF_TICKS_PER_S, the faster wheel is slipping — trust the slower
    (gripping) wheel and rebuild the faster one from it + the commanded turn
    (#1 + #3 merged). Odometry now runs on these slip-corrected deltas;
    maneuver tick-counting still uses raw deltas. Real commanded turns are
    preserved (only un-commanded divergence is dropped).
    [follow.py]
2026-06-04 Make follow.py the main program; remove A* pathfinder + arc-test + drive plumbing
    Delete Pathfinding_algorithm.py and pathfinding_arc_test.py and the old
    two-process launch infra (start_cart.sh, stop_cart.sh, systemd/ units +
    install.sh) that orchestrated them.
    vision/yolo_detect.py is now vision-only: drop 'import Pathfinding_algorithm',
    remove the drive run()/main (MotorDriver, Odometry, P.tick, P.S.mode) and
    the --no-drive flag; keep the IMX500 + ByteTrack target/obstacle tracking
    that follow.py imports, plus a vision-only preview run()/main.
    follow.py: drop the now-defunct Y.P.S.mode map-label write; refresh the
    self-contained spec comments. Update README to be follow.py-centric
    (remov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
2026-06-04 Add cart-follow.service autostart for follow.py; remove unrelated throttle_watch.sh
    systemd/cart-follow.service runs 'follow.py --no-display' headless on
    boot (enable with systemctl enable --now cart-follow), documented in the
    README. Delete vision/throttle_watch.sh — a Mac training thermal monitor
    unrelated to the cart/follow.
2026-06-04 Switch vision detector to YOLO11n
2026-06-04 Skip annotation drawing in headless follow
    [follow.py, follow_straight.py, yolo_detect.py]
2026-06-05 follow.py: 10s vision warmup at startup, then 360deg inertia calibration
    Add a VISION_WARMUP_S (10s) _warmup_vision() loop that runs the camera +
    ByteTrack + TargetLock pipeline with no drive so the colour tracking
    settles on the shopper before the cart moves. Change
    calibrate_angular_inertia to spin one full revolution (spin_revs=1.0,
    encoder-yaw gated, adaptive timeout) instead of stopping at steady_ticks.
    Startup order is now: warmup -> countdown -> 360deg calibration -> follow.
2026-06-05 calibrate_angular_inertia: ramp the spin kick if it can't break free
    Phase 1 now starts at SPIN_KICK_RPM and ramps by KICK_RAMP_STEP each
    KICK_TIMEOUT_S it barely turns (<5deg), up to MAX_RPM — the same
    ramp-on-stall the forward Kick uses — instead of a fixed timeout giving
    up. Only gives up if even MAX_RPM won't spin it. The coast->inertia
    compute now uses the actual final spin RPM (post-ramp), not SPIN_KICK_RPM.
    [follow.py]
2026-06-05 follow.py: follow-while-steering; lost = pursue-then-search
    Follow now steers toward the target while driving forward (no blocking
    in-place re-centre spin that let the shopper get away). Lost handling:
    if last seen near centre (|angle|<=LOST_SIDE_ANGLE_DEG) it walked too far
    -> PURSUE forward, and if still not found -> spin-SEARCH; if last seen out
    to the side -> spin-SEARCH directly. SEARCH (Searcher) now spins in place
    forever with a ramp-on-stall and never gives up.
    [follow.py]
2026-06-05 follow.py: centring spins drive forward + online ANGULAR_INERTIA refine
    Restore drift-compensated centring spins (Spinner) when |angle| >
    THETA_THRESH_DEG, but add the distance controller's forward speed to the
    spin's wheel commands so the cart keeps closing on the shopper instead of
    stalling in place. After each spin, the next frame's leftover target
    angle is the over/undershoot: nudge ANGULAR_INERTIA (overshoot -> more,
    undershoot -> less, learn rate INERTIA_LEARN_K), seeded by the startup
    360 calibration. In-band (<=THETA_THRESH) still steers while driving.
    [follow.py]
2026-06-05 Update yolo_detect.py
    reverted to hsv filtering
2026-06-05 follow.py: fix return-home detection + obstacle-avoidance reliability
    Return-home: the old detector only accumulated rotation while commanding
    a full stop, but the cart is rarely stopped and a manual spin makes it
    search (which reset the accumulator) — so 180deg never triggered. Now
    accumulate (measured yaw - commanded yaw) every tick: a manual spin adds
    to measured but not commanded, so it registers whether following,
    stopped, or searching. Commanded spins track (measured~commanded) so they
    don't drift. Reset on return-home start AND completion.
    Obstacle: the per-frame any() check flickered with noisy distance/angle
    and 1-frame dropouts, so the cart lurched forward. Add hysteresis
    (OBSTA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
    [follow.py]
2026-06-05 README: update return-home detection (measured-commanded yaw) + obstacle hysteresis
2026-06-05 Stabilize YOLO model path handling
    [follow.py, yolo_detect.py]
2026-06-05 Slow search and calibration spins
2026-06-05 Revert "Slow search and calibration spins"
    This reverts commit e52fb7d6cb0609a7d9bfdd07011b3092b7a2fad1.
    [follow.py]
2026-06-05 Revert "Make boot follower startup resilient"
    This reverts commit 5c65cc42bdda72b38cbc17e30779d298770eac18.
    [follow.py]
2026-06-05 follow.py: disable pursue for now (PURSUE_ENABLED=False)
    When the target is lost the cart always spin-searches; forward pursue is
    gated behind PURSUE_ENABLED (off). Flip back to True to re-enable.
    [follow.py]
2026-06-05 removed initiail calibration and tuning constants
2026-06-05 Revert "Periodically relock target by color similarity"
    This reverts commit ce29ee66df659a74bfd273c65465434aa6f905ef.
    [yolo_detect.py]
2026-06-10 Fix forward/backward jerkiness: damped-P distance law + coast compensation
    - MAX_RPM 800 -> 100: firmware maps 100 to full PWM, so the old cap let the
    integrator wind up 8x past saturation (erasing steering and overshooting)
    - Replace integrating S += KP*dx law with follow_straight's damped P:
    deadband + restart hysteresis + slew limiting kills the stop/kick/stop
    limit cycle at the 2 m hold ring (sim: 25 stop/go flips -> 1)
    - LINEAR_INERTIA now learned online from every commanded stop (coast
    distance / speed, like the spin-inertia refine) and used to brake early:
    error -= v * LINEAR_INERTIA
    - Lost-target grace now coasts down on the slew instead of brake-slamming
    on a one-frame l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
    [follow.py]
2026-06-10 Continuous steering: kill spin pulses, learn both inertias online, drop startup calibration
    - Steering is now a continuous damped-P law, the angular twin of the
    distance fix: rpm_diff = KP_ANGLE*(theta - omega*ANGULAR_INERTIA) every
    tick, with angle deadband + slew limiting. The discrete Spinner (point
    turn pulsed at the 18 deg threshold) had the same limit-cycle problem the
    forward controller had at the hold ring - removed entirely; the shopper
    is steered back to centre while driving and via gentle standing turns.
    - ANGULAR_INERTIA: no startup 360 spin. A generic InertiaLearner (one
    instance per axis, replaces CoastLearner + the spin-residual refine)
    measures coast/rate at eve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
    [follow.py]
2026-06-10 Website: real demo footage, vision view, and build photos
    - 'Watch it work' section: courtyard follow video (trimmed to the 21 s of
    action, 540x960 H.264, autoplay-muted loop that pauses offscreen) beside
    the cart's-eye screen recording (click-to-play, H.264 from HEVC)
    - 'What the cart actually sees' explainer with the annotated TARGET/
    OBSTACLE frame in the How-it-works section
    - 'Designed in CAD / built by hand' strip with the chassis render and the
    real prototype photo in the hardware section
    - og:image social card from the prototype photo; Demo nav link; hero CTA
    now points at the footage
2026-06-10 Website: colour-lock and controls/calibration explainers, full team credit
    - 'How it knows it's you': animated fingerprint diagram (outfit scan ->
    colour fingerprint -> per-person similarity scores), three explainer
    cards, privacy note
    - 'Smooth on purpose': three illustrated control ideas - speed-matches-
    the-gap scene, animated first-stop-vs-learned-stop coast comparison,
    kick speed curve - in alternating rows
    - Footer credits Terrence Lei, Jonah Lee, Damian Martinez & Jack Lei
    - Nav links for both new sections
2026-06-10 Site: fix clipped fingerprint caption (two lines), add 4-hour battery life (stats strip + hardware card), americanize all spelling repo-wide
    [follow.py, follow_straight.py, vision_weight_trainer.py, yolo_detect.py]
2026-06-10 Site: relatable 30 fps comparisons, regression-weights note, smooth coast deceleration
    - 30x/sec framed as 'more often than a movie changes frames' and 'ten
    looks per blink of an eye'
    - color-lock card mentions the regression-trained HSV weights that keep
    the match stable through shadows and lighting changes
    - coast-learning animation: velocity-matched keySplines so the drive ends
    at cruise speed and the coast is one continuous deceleration onto the
    final spot (was: ease to a stop at power-off, then lurch); loop rewind
    hidden with an opacity fade
2026-06-10 Hero sim: direct pursuit, FOV re-lock, true distances; nav clipping; dual autoplay
    - Cart is now a free agent that pursues the shopper directly instead of
    replaying the route: heading steers at the person, speed = KP*(straight-
    line distance error). Fixes 'follows the old path' and the inflated
    along-path distance readout - the label now shows true line-of-sight
    meters.
    - Re-lock the moment the shopper enters the spinning FOV (cone-bearing
    test) and drive straight to them; shelf-slide steering (Liang-Barsky
    look-ahead + edge slide + push-out) noses around shelf ends so direct
    pursuit never crosses a shelf. Verified headlessly over 6 loops: zero
    shelf penetration, one 7-10 s s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
2026-06-10 Site: tighten all copy — short sentences, one idea each (38 blocks simplified)
